Kostecki/Spinning-Platform/hardware/main-board/main-board.kicad_pcb

## KiCad design hardware/main-board/main-board.kicad_pcb (2026-11-09)

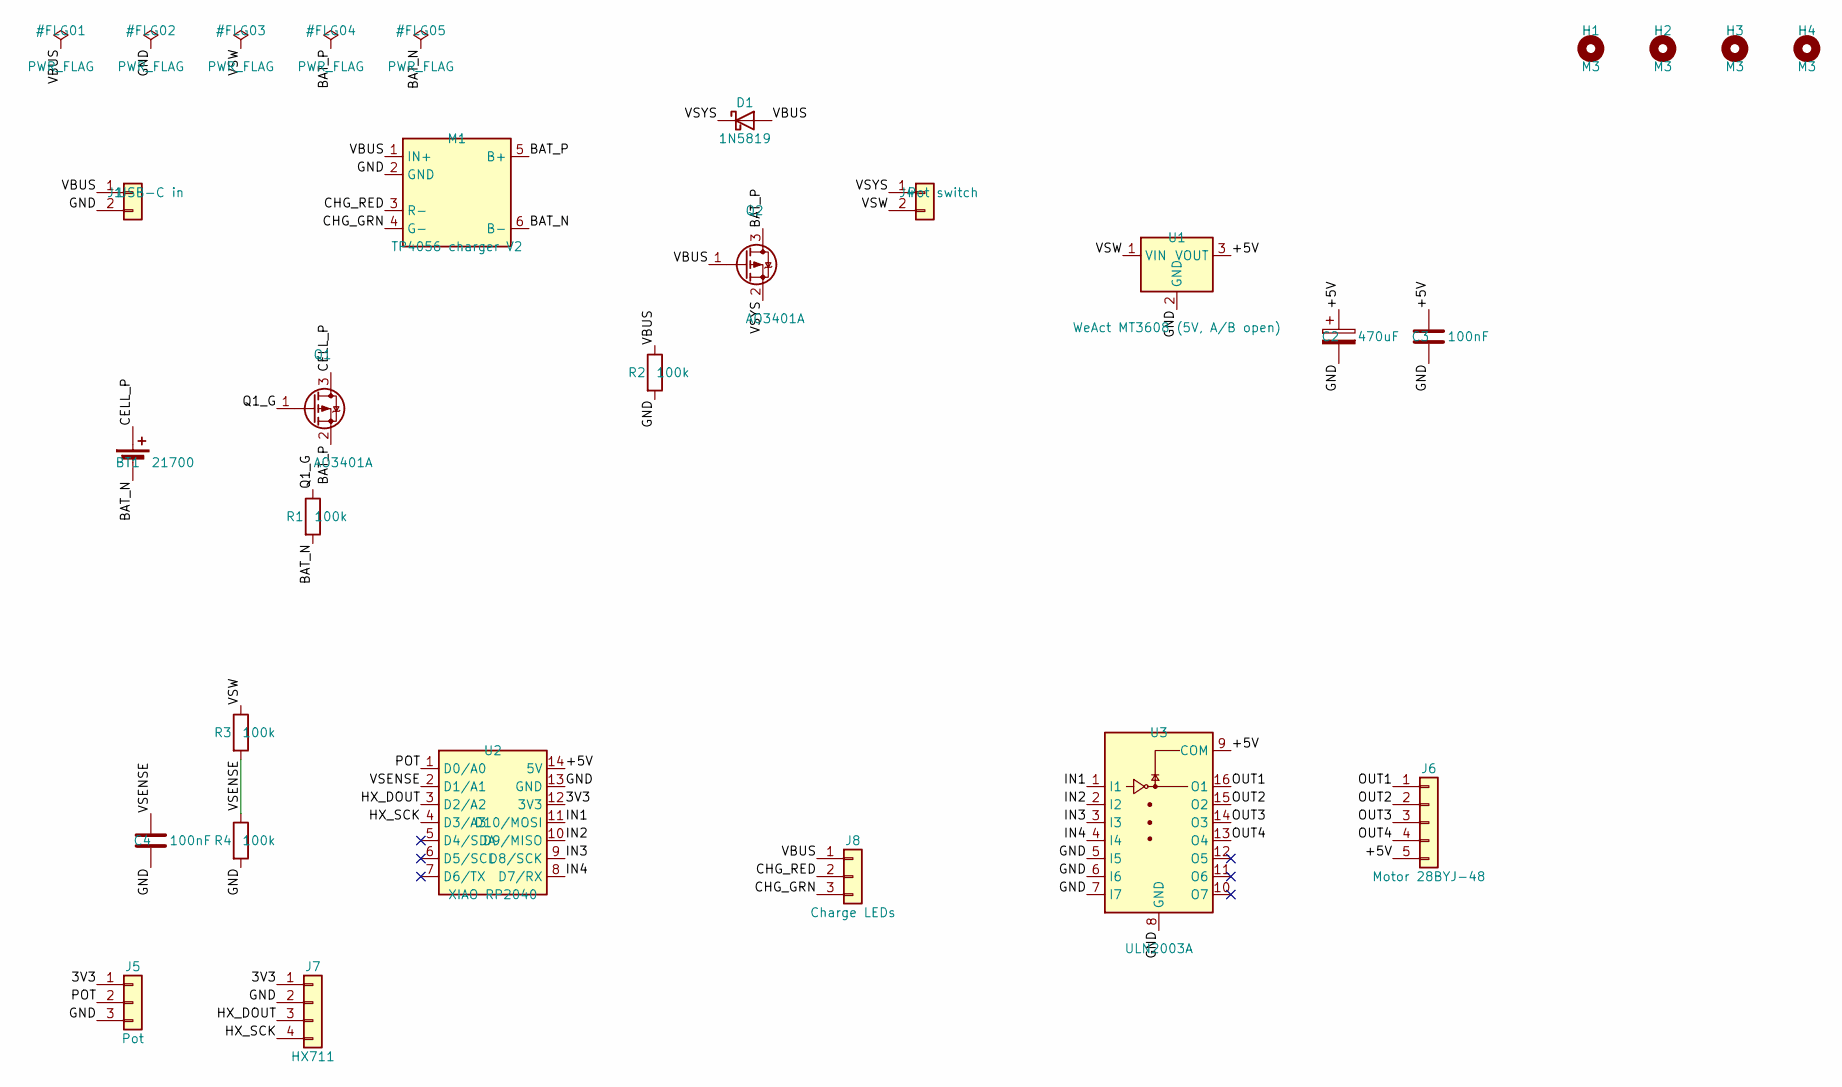
[picture p1: schematic main-board.kicad_sch]

Parts:
BT1: 21700; BH-21700-A5BJ001
C2: 470uF; CP_Radial_D6.3mm_P2.50mm
C3, C4: 100nF; C_Disc_D5.0mm_W2.5mm_P5.00mm
D1: 1N5819; D_DO-41_SOD81_P10.16mm_Horizontal
H1, H2, H3, H4: M3; MountingHole_3.2mm_M3
J1: USB-C in; PhoenixContact_MCV_1,5_2-G-3.5_1x02_P3.50mm_Vertical
J4: Pot switch; JST_XH_S2B-XH-A_1x02_P2.50mm_Horizontal
J5: Pot; JST_XH_S3B-XH-A_1x03_P2.50mm_Horizontal
J6: Motor 28BYJ-48; JST_XH_B5B-XH-A_1x05_P2.50mm_Vertical
J7: HX711; PinHeader_1x04_P2.54mm_Vertical
J8: Charge LEDs; PhoenixContact_MCV_1,5_3-G-3.5_1x03_P3.50mm_Vertical
M1: TP4056 charger V2; TP4056_Charger_V2
Q1, Q2: AO3401A; SOT-23_Handsoldering
R1, R2, R3, R4: 100k; R_Axial_DIN0207_L6.3mm_D2.5mm_P7.62mm_Horizontal
U1: WeAct MT3608 (5V, A/B open); WeAct_MT3608
U2: XIAO RP2040; Seeed_XIAO_Socketed
U3: ULN2003A; DIP-16_W7.62mm_Socket

Connections:
/3V3: J5.1, J7.1, U2.12 (3V3)
/+5V: C2.1, C3.1, J6.5, U1.3 (VOUT), U2.14 (5V), U3.9 (COM)
/BAT_N: BT1.2 (-), M1.6 (B-), R1.2
/BAT_P: M1.5 (B+), Q1.2 (S), Q2.3 (D)
/CELL_P: BT1.1 (+), Q1.3 (D)
/CHG_GRN: J8.3, M1.4 (G-)
/CHG_RED: J8.2, M1.3 (R-)
/GND: C2.2, C3.2, C4.2, J1.2, J5.3, J7.2, M1.2 (GND), R2.2, R4.2, U1.2 (GND), U2.13 (GND), U3.5 (I5), U3.6 (I6), U3.7 (I7), U3.8 (GND)
/HX_DOUT: J7.3, U2.3 (D2/A2)
/HX_SCK: J7.4, U2.4 (D3/A3)
/IN1: U2.11 (D10/MOSI), U3.1 (I1)
/IN2: U2.10 (D9/MISO), U3.2 (I2)
/IN3: U2.9 (D8/SCK), U3.3 (I3)
/IN4: U2.8 (D7/RX), U3.4 (I4)
/OUT1: J6.1, U3.16 (O1)
/OUT2: J6.2, U3.15 (O2)
/OUT3: J6.3, U3.14 (O3)
/OUT4: J6.4, U3.13 (O4)
/POT: J5.2, U2.1 (D0/A0)
/Q1_G: Q1.1 (G), R1.1
/VBUS: D1.2 (A), J1.1, J8.1, M1.1 (IN+), Q2.1 (G), R2.1
/VSENSE: C4.1, R3.2, R4.1, U2.2 (D1/A1)
/VSW: J4.2, R3.1, U1.1 (VIN)
/VSYS: D1.1 (K), J4.1, Q2.2 (S)

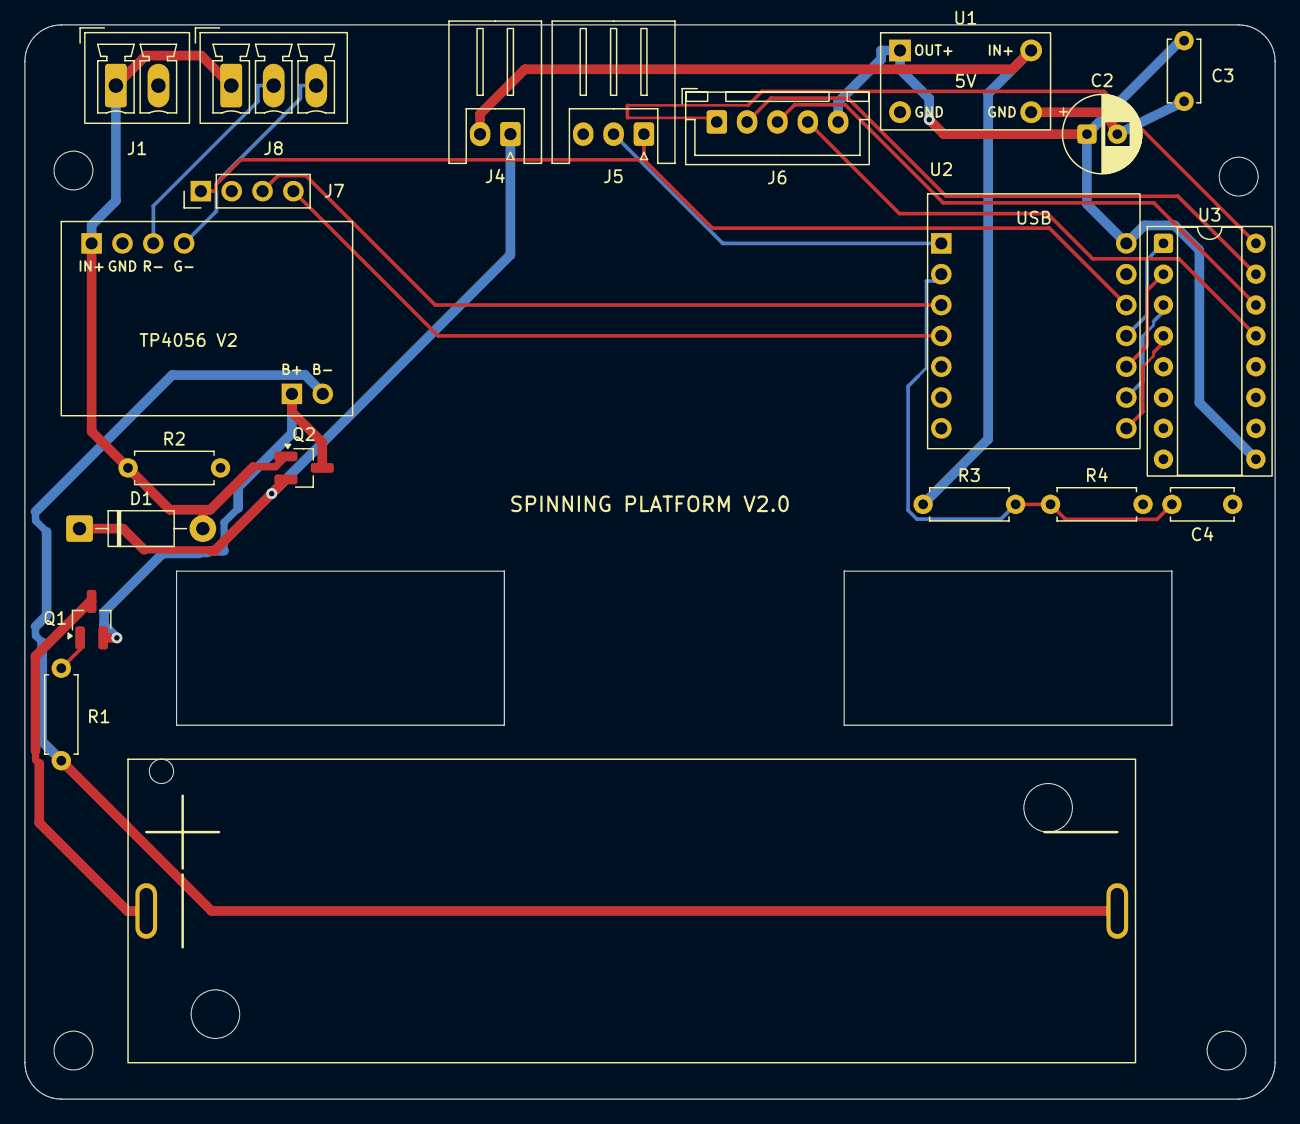
[picture p2: board main-board.kicad_pcb from above]

Board: 2 copper layers, 103.0 x 88.5 mm, 25 parts (0 on the bottom side), 24 nets.
