Kostecki/Spinning-Platform/(commit log)

2026-11-08 V2 main board, case model, SAMD21 flash storage
2026-11-08 Main board: WeAct MT3608 boost, vertical USB/LED headers, silkscreen cleanup
2026-11-08 Case: 72 mm bearing, platform coverage checks
2026-11-09 Case: parametric Fusion model with whole-case weighing
2026-11-09 Main board: post and pillar cutouts for whole-case weighing
